dwilson2547/race-logger/(commit log)

2026-11-08 Add the XIAO S3 designs: pin plan and Robo Capture sketch
    Both moved from robo-services; neither was built.
2026-11-08 Add the v1 race logger and give each version its own folder
    v1 comes back from robo-services history; each folder holds its photo.
    README gains the device lineage.
